parastuffs/mesange_keyboard/(threads)

Thread 2 (2021-10-21):

A question about the matrix_init function

myst729, 2021-10-21:
In [config.h](https://github.com/parastuffs/mesange_keyboard/blob/main/9-keys-74hc595/firmware/9keysSR/config.h#L17-L20) you defined row pins as:
```c
/* row pins */
#define ROW_A  C6
#define ROW_B  D7
#define ROW_C  E6
```

But in [matrix.c](https://github.com/parastuffs/mesange_keyboard/blob/main/9-keys-74hc595/firmware/9keysSR/matrix.c#L61-L72), the `matrix_init` function set pin input for rows as:
```c
/**
 * Row pins PD2, PD3... PD7 are input for rows A-F.
 * The rows are pulled low with a pull-down resistor.
 *
 * The columns are scanned using two 74hc595 in series on pins defined in config.h.
 */
void matrix_init(void) {
    setPinInput(D5); /* Arduino denomination */
    setPinInput(D6);
    setPinInput(D7);
```

I couldn't figure out the relation between the row pins and the pin input being set. Also the comment for the function is confusing. Could you share some insight?

Closed 2021-11-09.
