parastuffs/mesange_keyboard/(commit log)

2021-01-23 [AVR] Blinky: actually blinks the RX LED.
2021-02-21 9 keys
    [9keys.kicad_pcb, 9keys.sch]
2021-02-24 [9keys74HC595] 9 keys with shift register, writeup and doc incoming.
    [9keys.kicad_pcb, 9keys.sch]
